aakashvishcoder/mini-reef/mini-reef.kicad_pcb

## KiCad design mini-reef.kicad_pcb (2026-11-12)

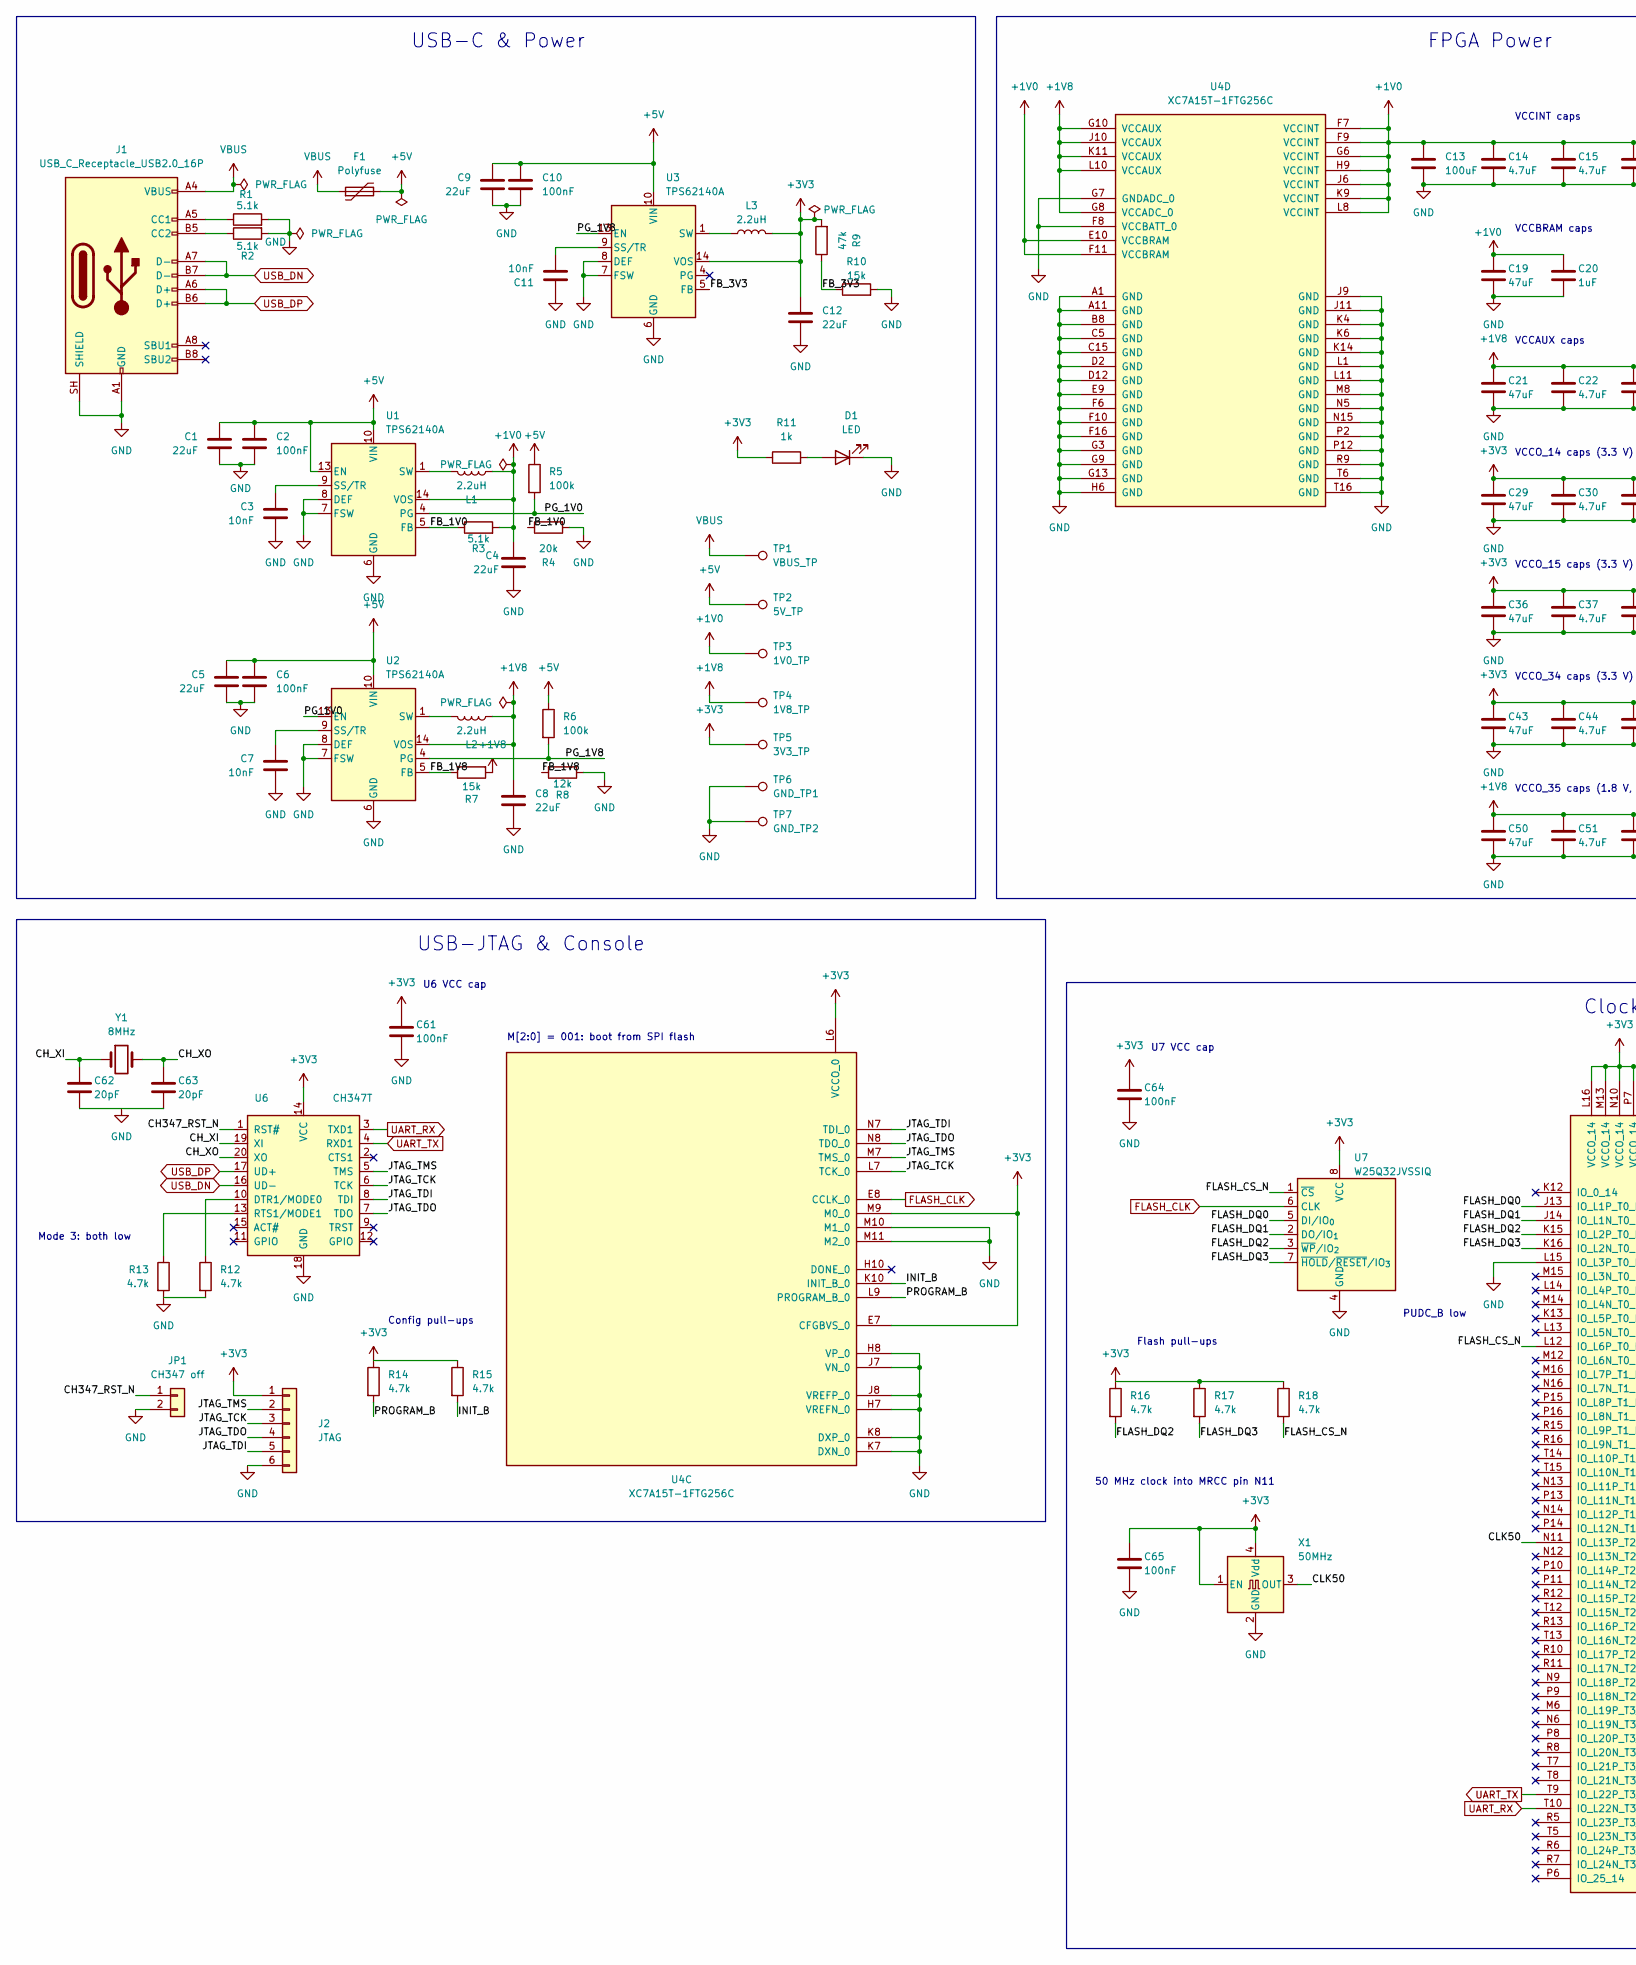
[picture p1: schematic mini-reef.kicad_sch, part in row 1, column 1]

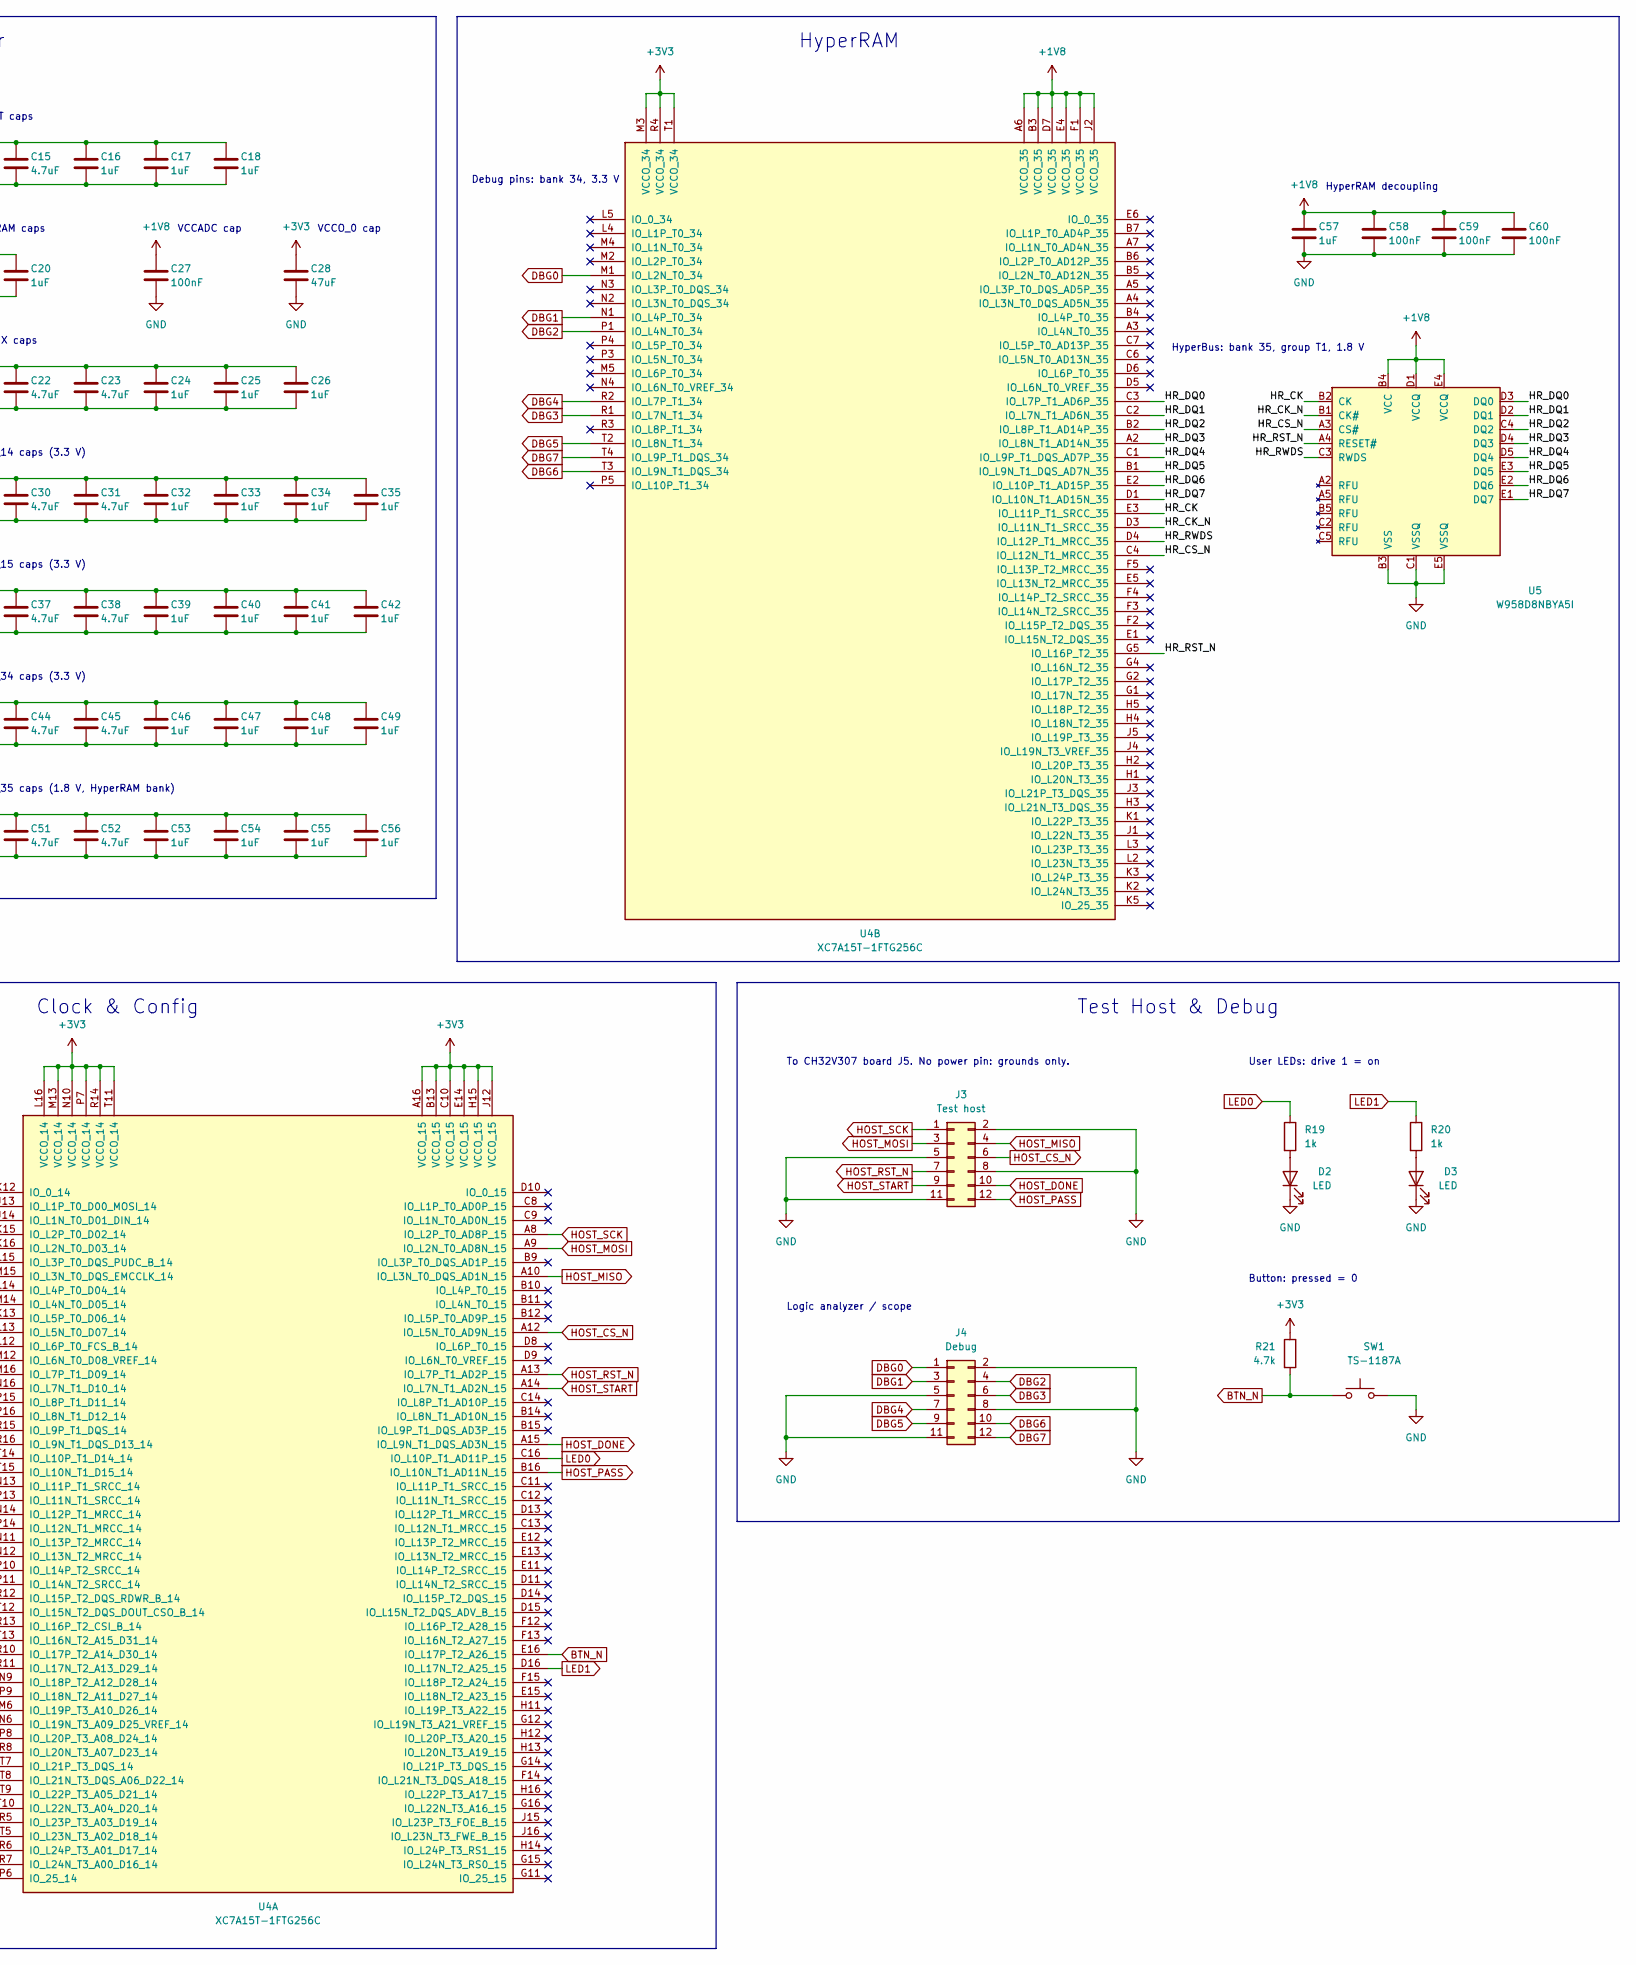
[picture p2: schematic mini-reef.kicad_sch, part in row 1, column 2]

Parts:
C1, C4, C5, C8, C9, C12: 22uF; C_0805_2012Metric; LCSC C45783
C2, C6, C10, C27, C58, C59, C60, C61, C64, C65: 100nF; C_0402_1005Metric; LCSC C1525
C3, C7, C11: 10nF; C_0402_1005Metric; LCSC C15195
C13: 100uF; C_1206_3216Metric; LCSC C15008
C14, C15, C22, C23, C30, C31, C37, C38, C44, C45, C51, C52: 4.7uF; C_0805_2012Metric; LCSC C1779
C16, C17, C18, C20, C24, C25, C26, C32, C33, C34, C35, C39, C40, C41, C42, C46, C47, C48, C49, C53, C54, C55, C56, C57: 1uF; C_0402_1005Metric; LCSC C52923
C19, C21, C28, C29, C36, C43, C50: 47uF; C_1206_3216Metric; LCSC C96123
C62, C63: 20pF; C_0402_1005Metric; LCSC C1554
D1, D2, D3: LED; LED_0603_1608Metric; LCSC C2286
F1: Polyfuse; Fuse_1206_3216Metric; LCSC C20801
J1: USB_C_Receptacle_USB2.0_16P; USB_C_Receptacle_HRO_TYPE-C-31-M-12; LCSC C165948
J2: JTAG; PinHeader_1x06_P2.54mm_Vertical
J3: Test host; PinHeader_2x06_P2.54mm_Vertical
J4: Debug; PinHeader_2x06_P2.54mm_Vertical
JP1: CH347 off; PinHeader_1x02_P2.54mm_Vertical
L1, L2, L3: 2.2uH; IND-SMD_L4.5-W4.1_SRP4020TA; LCSC C719179
R1, R2, R3: 5.1k; R_0402_1005Metric; LCSC C25905
R4: 20k; R_0402_1005Metric; LCSC C25765
R5, R6: 100k; R_0402_1005Metric; LCSC C25741
R7, R10: 15k; R_0402_1005Metric; LCSC C25756
R8: 12k; R_0402_1005Metric; LCSC C25752
R9: 47k; R_0402_1005Metric; LCSC C25792
R11, R19, R20: 1k; R_0402_1005Metric; LCSC C11702
R12, R13, R14, R15, R16, R17, R18, R21: 4.7k; R_0402_1005Metric; LCSC C25900
SW1: TS-1187A; SW_Push_1P1T_XKB_TS-1187A; LCSC C318884
TP1: VBUS_TP; TestPoint_Pad_D1.5mm
TP2: 5V_TP; TestPoint_Pad_D1.5mm
TP3: 1V0_TP; TestPoint_Pad_D1.5mm
TP4: 1V8_TP; TestPoint_Pad_D1.5mm
TP5: 3V3_TP; TestPoint_Pad_D1.5mm
TP6: GND_TP1; TestPoint_Pad_D1.5mm
TP7: GND_TP2; TestPoint_Pad_D1.5mm
U1, U2, U3: TPS62140A; VQFN-16-1EP_3x3mm_P0.5mm_EP1.68x1.68mm_ThermalVias; LCSC C129366
U4: XC7A15T-1FTG256C; Xilinx_FTG256; LCSC C1521788
U5: W958D8NBYA5I; BGA-24_6x8mm_Layout5x5_P1.0mm; LCSC C7420405
U6: CH347T; TSSOP-20_4.4x6.5mm_P0.65mm; LCSC C5122332
U7: W25Q32JVSSIQ; SOIC-8_5.3x5.3mm_P1.27mm; LCSC C179173
X1: 50MHz; Oscillator_SMD_Abracon_ASE-4Pin_3.2x2.5mm; LCSC C717684
Y1: 8MHz; Crystal_SMD_5032-2Pin_5.0x3.2mm; LCSC C115962

Connections:
+1V0: C4.1, C13.1, C14.1, C15.1, C16.1, C17.1, C18.1, C19.1, C20.1, L1.2, R3.2, TP3.1, U1.14 (VOS), U4.E10 (VCCBRAM), U4.F7 (VCCINT), U4.F9 (VCCINT), U4.F11 (VCCBRAM), U4.G6 (VCCINT), U4.H9 (VCCINT), U4.J6 (VCCINT), U4.K9 (VCCINT), U4.L8 (VCCINT)
+1V8: C8.1, C21.1, C22.1, C23.1, C24.1, C25.1, C26.1, C27.1, C50.1, C51.1, C52.1, C53.1, C54.1, C55.1, C56.1, C57.1, C58.1, C59.1, C60.1, L2.2, R7.2, TP4.1, U2.14 (VOS), U4.A6 (VCCO_35), U4.B3 (VCCO_35), U4.D7 (VCCO_35), U4.E4 (VCCO_35), U4.F1 (VCCO_35), U4.G8 (VCCADC_0), U4.G10 (VCCAUX), U4.J2 (VCCO_35), U4.J10 (VCCAUX), U4.K11 (VCCAUX), U4.L10 (VCCAUX), U5.B4 (VCC), U5.D1 (VCCQ), U5.E4 (VCCQ)
+3V3: C12.1, C28.1, C29.1, C30.1, C31.1, C32.1, C33.1, C34.1, C35.1, C36.1, C37.1, C38.1, C39.1, C40.1, C41.1, C42.1, C43.1, C44.1, C45.1, C46.1, C47.1, C48.1, C49.1, C61.1, C64.1, C65.1, J2.1, L3.2, R9.2, R11.1, R14.1, R15.1, R16.1, R17.1, R18.1, R21.1, TP5.1, U3.14 (VOS), U4.A16 (VCCO_15), U4.B13 (VCCO_15), U4.C10 (VCCO_15), U4.E7 (CFGBVS_0), U4.E14 (VCCO_15), U4.H15 (VCCO_15), U4.J12 (VCCO_15), U4.L6 (VCCO_0), U4.L16 (VCCO_14), U4.M3 (VCCO_34), U4.M9 (M0_0), U4.M13 (VCCO_14), U4.N10 (VCCO_14), U4.P7 (VCCO_14), U4.R4 (VCCO_34), U4.R14 (VCCO_14), U4.T1 (VCCO_34), U4.T11 (VCCO_14), U6.14 (VCC), U7.8 (VCC), X1.1 (EN), X1.4 (Vdd)
+5V: C1.1, C2.1, C5.1, C6.1, C9.1, C10.1, F1.2, R5.1, R6.1, TP2.1, U1.10 (VIN), U1.11 (VIN), U1.12 (VIN), U1.13 (EN), U2.10 (VIN), U2.11 (VIN), U2.12 (VIN), U3.10 (VIN), U3.11 (VIN), U3.12 (VIN)
/CH347_RST_N: JP1.1, U6.1 (RST#)
/CH_XI: C62.1, U6.19 (XI), Y1.1
/CH_XO: C63.1, U6.20 (XO), Y1.2
/CLK50: U4.N11 (IO_L13P_T2_MRCC_14), X1.3 (OUT)
/FB_1V0: R3.1, R4.1, U1.5 (FB)
/FB_1V8: R7.1, R8.2, U2.5 (FB)
/FB_3V3: R9.1, R10.1, U3.5 (FB)
/FLASH_CS_N: R18.2, U4.L12 (IO_L6P_T0_FCS_B_14), U7.1 (~CS)
/FLASH_DQ0: U4.J13 (IO_L1P_T0_D00_MOSI_14), U7.5 (DI/IO_{0})
/FLASH_DQ1: U4.J14 (IO_L1N_T0_D01_DIN_14), U7.2 (DO/IO_{1})
/FLASH_DQ2: R16.2, U4.K15 (IO_L2P_T0_D02_14), U7.3 (~WP/IO_{2})
/FLASH_DQ3: R17.2, U4.K16 (IO_L2N_T0_D03_14), U7.7 (~HOLD/~RESET/IO_{3})
/HR_CK: U4.E3 (IO_L11P_T1_SRCC_35), U5.B2 (CK)
/HR_CK_N: U4.D3 (IO_L11N_T1_SRCC_35), U5.B1 (CK#)
/HR_CS_N: U4.C4 (IO_L12N_T1_MRCC_35), U5.A3 (CS#)
/HR_DQ0: U4.C3 (IO_L7P_T1_AD6P_35), U5.D3 (DQ0)
/HR_DQ1: U4.C2 (IO_L7N_T1_AD6N_35), U5.D2 (DQ1)
/HR_DQ2: U4.B2 (IO_L8P_T1_AD14P_35), U5.C4 (DQ2)
/HR_DQ3: U4.A2 (IO_L8N_T1_AD14N_35), U5.D4 (DQ3)
/HR_DQ4: U4.C1 (IO_L9P_T1_DQS_AD7P_35), U5.D5 (DQ4)
/HR_DQ5: U4.B1 (IO_L9N_T1_DQS_AD7N_35), U5.E3 (DQ5)
/HR_DQ6: U4.E2 (IO_L10P_T1_AD15P_35), U5.E2 (DQ6)
/HR_DQ7: U4.D1 (IO_L10N_T1_AD15N_35), U5.E1 (DQ7)
/HR_RST_N: U4.G5 (IO_L16P_T2_35), U5.A4 (RESET#)
/HR_RWDS: U4.D4 (IO_L12P_T1_MRCC_35), U5.C3 (RWDS)
/INIT_B: R15.2, U4.K10 (INIT_B_0)
/JTAG_TCK: J2.3, U4.L7 (TCK_0), U6.6 (TCK)
/JTAG_TDI: J2.5, U4.N7 (TDI_0), U6.8 (TDI)
/JTAG_TDO: J2.4, U4.N8 (TDO_0), U6.7 (TDO)
/JTAG_TMS: J2.2, U4.M7 (TMS_0), U6.5 (TMS)
/PG_1V0: R5.2, U1.4 (PG), U2.13 (EN)
/PG_1V8: R6.2, U2.4 (PG), U3.13 (EN)
/PROGRAM_B: R14.2, U4.L9 (PROGRAM_B_0)
BTN_N: R21.2, SW1.1, U4.E16 (IO_L17P_T2_A26_15)
DBG0: J4.1, U4.M1 (IO_L2N_T0_34)
DBG1: J4.3, U4.N1 (IO_L4P_T0_34)
DBG2: J4.4, U4.P1 (IO_L4N_T0_34)
DBG3: J4.6, U4.R1 (IO_L7N_T1_34)
DBG4: J4.7, U4.R2 (IO_L7P_T1_34)
DBG5: J4.9, U4.T2 (IO_L8N_T1_34)
DBG6: J4.10, U4.T3 (IO_L9N_T1_DQS_34)
DBG7: J4.12, U4.T4 (IO_L9P_T1_DQS_34)
FLASH_CLK: U4.E8 (CCLK_0), U7.6 (CLK)
GND: C1.2, C2.2, C3.2, C4.2, C5.2, C6.2, C7.2, C8.2, C9.2, C10.2, C11.2, C12.2, C13.2, C14.2, C15.2, C16.2, C17.2, C18.2, C19.2, C20.2, C21.2, C22.2, C23.2, C24.2, C25.2, C26.2, C27.2, C28.2, C29.2, C30.2, C31.2, C32.2, C33.2, C34.2, C35.2, C36.2, C37.2, C38.2, C39.2, C40.2, C41.2, C42.2, C43.2, C44.2, C45.2, C46.2, C47.2, C48.2, C49.2, C50.2, C51.2, C52.2, C53.2, C54.2, C55.2, C56.2, C57.2, C58.2, C59.2, C60.2, C61.2, C62.2, C63.2, C64.2, C65.2, D1.1 (K), D2.1 (K), D3.1 (K), J1.A1 (GND), J1.A12 (GND), J1.B1 (GND), J1.B12 (GND), J1.SH (SHIELD), J2.6, J3.2, J3.5, J3.8, J3.11, J4.2, J4.5, J4.8, J4.11, JP1.2, R1.2, R2.2, R4.2, R8.1, R10.2, R12.2, R13.2, SW1.2, TP6.1, TP7.1, U1.6 (GND), U1.7 (FSW), U1.8 (DEF), U1.15 (GND), U1.16 (GND), U1.17 (GND), U2.6 (GND), U2.7 (FSW), U2.8 (DEF), U2.15 (GND), U2.16 (GND), U2.17 (GND), U3.6 (GND), U3.7 (FSW), U3.8 (DEF), U3.15 (GND), U3.16 (GND), U3.17 (GND), U4.A1 (GND), U4.A11 (GND), U4.B8 (GND), U4.C5 (GND), U4.C15 (GND), U4.D2 (GND), U4.D12 (GND), U4.E9 (GND), U4.F6 (GND), U4.F8 (VCCBATT_0), U4.F10 (GND), U4.F16 (GND), U4.G3 (GND), U4.G7 (GNDADC_0), U4.G9 (GND), U4.G13 (GND), U4.H6 (GND), U4.H7 (VREFN_0), U4.H8 (VP_0), U4.J7 (VN_0), U4.J8 (VREFP_0), U4.J9 (GND), U4.J11 (GND), U4.K4 (GND), U4.K6 (GND), U4.K7 (DXN_0), U4.K8 (DXP_0), U4.K14 (GND), U4.L1 (GND), U4.L11 (GND), U4.L15 (IO_L3P_T0_DQS_PUDC_B_14), U4.M8 (GND), U4.M10 (M1_0), U4.M11 (M2_0), U4.N5 (GND), U4.N15 (GND), U4.P2 (GND), U4.P12 (GND), U4.R9 (GND), U4.T6 (GND), U4.T16 (GND), U5.B3 (VSS), U5.C1 (VSSQ), U5.E5 (VSSQ), U6.18 (GND), U7.4 (GND), X1.2 (GND)
HOST_CS_N: J3.6, U4.A12 (IO_L5N_T0_AD9N_15)
HOST_DONE: J3.10, U4.A15 (IO_L9N_T1_DQS_AD3N_15)
HOST_MISO: J3.4, U4.A10 (IO_L3N_T0_DQS_AD1N_15)
HOST_MOSI: J3.3, U4.A9 (IO_L2N_T0_AD8N_15)
HOST_PASS: J3.12, U4.B16 (IO_L10N_T1_AD11N_15)
HOST_RST_N: J3.7, U4.A13 (IO_L7P_T1_AD2P_15)
HOST_SCK: J3.1, U4.A8 (IO_L2P_T0_AD8P_15)
HOST_START: J3.9, U4.A14 (IO_L7N_T1_AD2N_15)
LED0: R19.1, U4.C16 (IO_L10P_T1_AD11P_15)
LED1: R20.1, U4.D16 (IO_L17N_T2_A25_15)
unnamed: D1.2 (A), R11.2
unnamed: D2.2 (A), R19.2
unnamed: D3.2 (A), R20.2
unnamed: J1.A5 (CC1), R1.1
unnamed: J1.B5 (CC2), R2.1
unnamed: L1.1, U1.1 (SW), U1.2 (SW), U1.3 (SW)
unnamed: L2.1, U2.1 (SW), U2.2 (SW), U2.3 (SW)
unnamed: L3.1, U3.1 (SW), U3.2 (SW), U3.3 (SW)
unnamed: C3.1, U1.9 (SS/TR)
unnamed: C7.1, U2.9 (SS/TR)
unnamed: C11.1, U3.9 (SS/TR)
unnamed: R12.1, U6.10 (DTR1/MODE0)
unnamed: R13.1, U6.13 (RTS1/MODE1)
UART_RX: U4.T10 (IO_L22N_T3_A04_D20_14), U6.3 (TXD1)
UART_TX: U4.T9 (IO_L22P_T3_A05_D21_14), U6.4 (RXD1)
USB_DN: J1.A7 (D-), J1.B7 (D-), U6.16 (UD-)
USB_DP: J1.A6 (D+), J1.B6 (D+), U6.17 (UD+)
VBUS: F1.1, J1.A4 (VBUS), J1.A9 (VBUS), J1.B4 (VBUS), J1.B9 (VBUS), TP1.1

Notes on the sheet:
USB-C & Power
VCCINT caps
VCCBRAM caps
VCCADC cap
VCCO_0 cap
VCCAUX caps
VCCO_14 caps (3.3 V)
VCCO_15 caps (3.3 V)
VCCO_34 caps (3.3 V)
VCCO_35 caps (1.8 V, HyperRAM bank)
HyperRAM decoupling
HyperBus: bank 35, group T1, 1.8 V
Debug pins: bank 34, 3.3 V
HyperRAM
FPGA Power
Mode 3: both low
U6 VCC cap
M[2:0] = 001: boot from SPI flash
Config pull-ups
USB-JTAG & Console
PUDC_B low
U7 VCC cap
Flash pull-ups
50 MHz clock into MRCC pin N11
Clock & Config
To CH32V307 board J5. No power pin: grounds only.
Logic analyzer / scope
User LEDs: drive 1 = on
Button: pressed = 0
Test Host & Debug

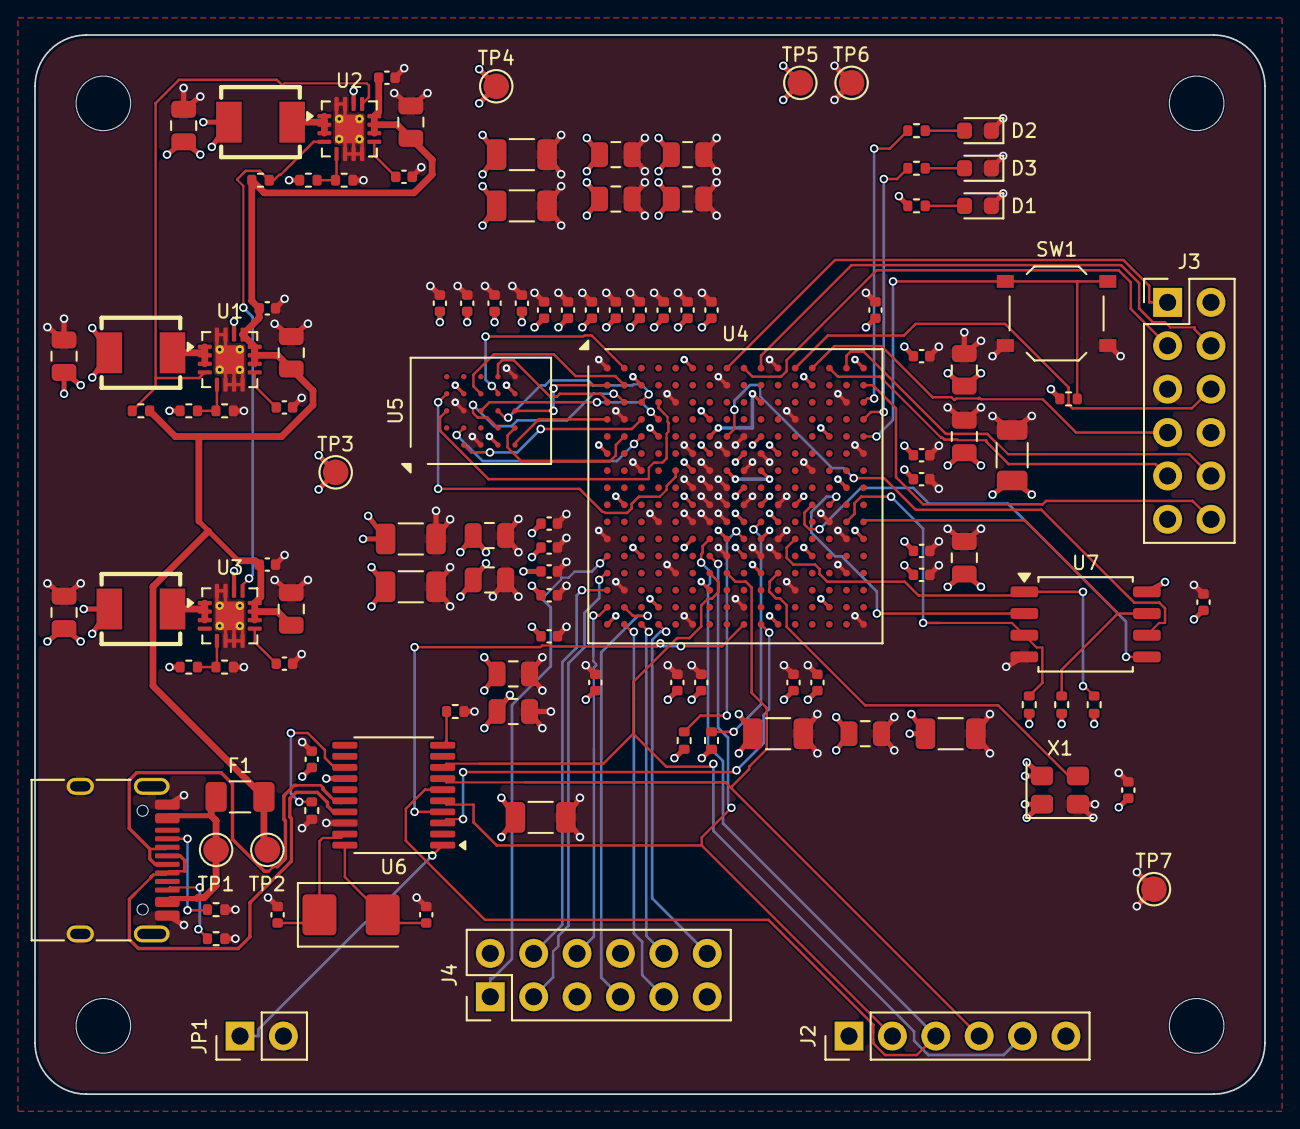
[picture p3: board mini-reef.kicad_pcb from above]

Board: 4 copper layers, 72.0 x 62.0 mm, 119 parts (0 on the bottom side), 76 nets.

Other parts of the board:
H1, H2, H3, H4: MountingHole_3.2mm_M3
