aakashvishcoder/mini-reef/(commit log)

2026-11-10 Project setup: section 1 guide, planning BOM, footprint library
    [planning-BOM.csv]
2026-11-10 Schematic guides for sections 2-6, full planning BOM, CH347T and HyperRAM symbols
    [planning-BOM.csv]
2026-11-10 Schematic: section 1 USB-C and power (ERC clean)
    [mini-reef.kicad_pcb, mini-reef.kicad_sch]
2026-11-12 Schematic: sections 2-6, schematic complete (0 ERC errors)
    [mini-reef.kicad_sch]
2026-11-12 Add Vivado pin constraints generated from the schematic netlist
2026-11-12 PCB: 4-layer layout, placement, power planes and routing (DRC clean)
    [mini-reef.kicad_pcb]
2026-11-12 Add JLCPCB order files (gerbers, BOM, CPL) and generator script
    [BOM.csv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]
2026-11-12 Swap regulators to TPS62140A (C129366): TPS62130A out of stock at JLC
    [BOM.csv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]
2026-11-13 Add FPGA pin check against AMD package pin files
